firestaradmin/WorldEdit-No.1/README.md

# 概要
基于STM32，极度硬核DIY蓝牙机械键盘，整个项目涵盖了 选轴体，键盘阵列排版，PCB设计，程序设计，外壳CNC制作。
