firestaradmin/WorldEdit-No.1/Code/WorldEdit_No_1_F103RCT6/DOC/ReadMe.txt

/************************************************************************************
*  Copyright (c), 2019, LXG.
*
* FileName		:ReadMe.txt
* Author		:firestaradmin
* Version		:1.3.2
*
*
*************************************************************************************/

================================================
History:
-------------------------------------------------
2020/1/29 :Version 1.3.2
增加了FN组合功能键， Consumer 按键 如音量加减等操作
修改USB模式的LOGO灯的常亮为可控制模式
-------------------------------------------------
2020/1/5 :Version 1.3.1
LED灯控关闭会自动点亮的bug被修复。
-------------------------------------------------
2019/12/20  ：Version:1.3
更新了USB——HID连接模式，响应时间有巨幅提高。游戏不在话下 
BLUETEETH_Mode:
响应时间:    14.07ms

USB_Mode:
响应时间：	0.34ms

-------------------------------------------------
2019/12/18  ：Version:1.2
bug修复
增加了键盘LED灯阵的操控
进一步提高了蓝牙的响应速度
但蓝牙模块已经到达极限速度，最快响应时间也不过15ms尔尔

-------------------------------------------------
2019/12/15  ：Version:1.0

键盘可以正常使用，有时候有一些bug
