firestaradmin/WorldEdit-No.1/LayOut/87.png

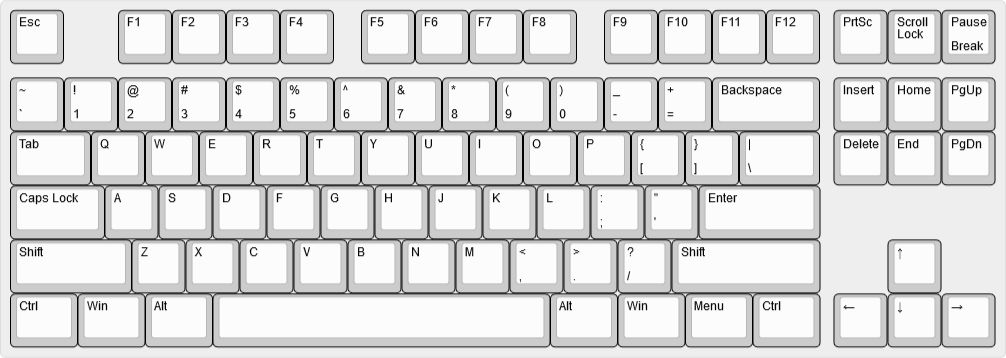
LayOut/87.png
