firestaradmin/WorldEdit-No.1/LayOut/89键盘矩阵.png

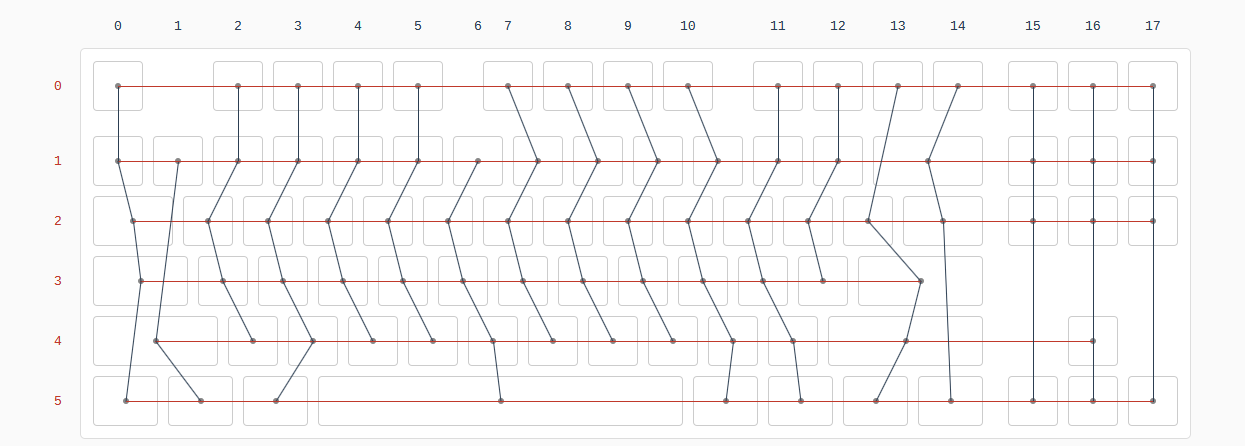
LayOut/89键盘矩阵.png
