firestaradmin/WorldEdit-No.1/PCB/创世一号/创世一号BOM.xls

Comment | Description | Designator | Footprint | LibRef | Quantity
HDR2x3 | Connector | BOOT | PIN-2x3-2.54-1.0 | HDR2x3 | 1
BTK-05-blueteeth |  | BTK-05 | BTK-05-bluteeth | BTK-05-blueteeth | 1
22pF | Capacitor | C1, C2 | RC0603 | CAP1 | 2
104 | Capacitor | C3, C4, C5, C6, C8 | RC0603 | CAP1 | 5
10uf | Tantalum Capacitor | C7 | CAP0805 | CAP-TANTALUM | 1
105 | Capacitor | C9, C12, C13, C16 | 0603 | CAP | 4
22nf | Capacitor | C10, C14 | 0603 | CAP | 2
104 | Capacitor | C11, C15 | 0603 | CAP | 2
10uf | Capacitor | C18, C19 | 0805 | CAP | 2
LED | LED | CAPS_LED, LED1, LED2, LED3, LED4, LED5, LED6, LED7, LED8, LED_CHRG, PWR, STATE_LED | LED-0805 | LED | 12
Diode |  | D2, D3, D4, D5, D6, D7, D8, D9, D10, D11, D12, D13, D14, D15, D16, D17, D18, D19, D20, D21, D22, D23, D24, D25, D26, D27, D28, D29, D30, D31, D32, D33, D34, D35, D36, D37, D38, D39, D40, D41, D42, D43, D44, D45, D46, D47, D48, D49, D50, D51, D52, D53, D54, D55, D56, D57, D58, D59, D60, D61, D62, D63, D64, D66, D67, D68, D69, D70, D71, D72, D73, D74, D75, D76, D77, D78, D82, D83, D84, D85, D86, D87, D88, D89, D90, D91, D92 | SDO-123 | Diode | 87
500mA | Resistor | F1 | 0805 | Res2 | 1
MX_SW | with Fixation pins 1-Pole w/LED | KEY_0, KEY_1, KEY_2, KEY_3, KEY_4, KEY_5, KEY_6, KEY_7, KEY_8, KEY_9, KEY_-, KEY_", KEY_/, KEY_;, KEY_[, KEY_\, KEY_], KEY_`, KEY_<, KEY_=, KEY_>, KEY_A, KEY_Alt, KEY_Alt2, KEY_B, KEY_Backspace, KEY_C, KEY_CapsLock, KEY_Ctrl, KEY_Ctrl2, KEY_D, KEY_Delete, KEY_Down, KEY_E, KEY_End, KEY_Enter, KEY_ESC, KEY_F, KEY_F1, KEY_F2, KEY_F3, KEY_F4, KEY_F5, KEY_F6, KEY_F7, KEY_F8, KEY_F9, KEY_F10, KEY_F11, KEY_F12, KEY_FN, KEY_G, KEY_H, KEY_Home, KEY_I, KEY_Insert, KEY_J, KEY_K, KEY_L, KEY_Left, KEY_M, KEY_Menu, KEY_N, KEY_O, KEY_P, KEY_PageDown, KEY_PageUp, KEY_Pause, KEY_PrtSc, KEY_Q, KEY_R, KEY_Right, KEY_S, KEY_ScrollLock, KEY_Shift, KEY_Shift2, KEY_Space, KEY_T, KEY_Tab, KEY_U, KEY_Up, KEY_V, KEY_W, KEY_Win, KEY_X, KEY_Y, KEY_Z | MX_SW-5 | MX_SW-5 | 87
HDR1x3 | Connector | LEDPwrCON | PIN-3-2.54-1.0 | HDR1x3 | 1
HDR1x2 | Connector | Power | PIN-2-2.54-1.0 | HDR1x2 | 1
NPN | NPN Bipolar Transistor | Q1 | S8050-TO-92 | NPN | 1
1M |  | R1 | RC0603 | R | 1
0R |  | R2 | RC0603 | R | 1
10K |  | R3, R4, R5 | RC0603 | R | 3
1k | Resistor, [NoValue] | R6, R7, R9, R13, R15, | 0603 | RES, R, Res2 | 5
1.5K | Resistor | R10 | 0603 | Res2 | 1
22R | Resistor | R11, R12,R17 | 0603 | Res2 | 3
10k | Resistor | R16 | 0603 | Res2 | 1
2k | Resistor | RPROG | 0603 | RES | 1
SW-SPST | Single-Pole, Single-Throw Switch | S1 | SMT-KEY | SW-SPST | 1
SWITCH-SPST | Switch | SW_PWR | Switch_3p_2.5mmjianju | SWITCH-SPST | 1
HDR1x4 | Connector | SWD | PIN-4-2.54-1.0 | HDR1x4 | 1
STM32F103RCT6 | MCU | U1 | QFP-64-0.5 | STM32F103RxTx | 1
HT16K33 SOP-28 |  | U2 | HT16K33-28PIN-SOP28 | HT16K33 SOP-28 | 1
RT9193 |  | U3, U4 | SOT-23-5 | RT9193 | 2
TP4056 |  | U5 | ESOP8 | TP4056 | 1
USB Slave_c | USB Connector | USB | MICRO USB CONNECTOR TYPEB-ST-MC-5F-01 | MICRO USB CONNECTOR TYPEB | 1
8M | Crystal Oscillator | X1 | HC49-SMD | XTAL_SMD | 1
名称 | 描述 | 封装 | 数量
HDR2x3 | Connector | PIN-2x3-2.54-1.0 | 1
BTK-05-blueteeth | 蓝牙HID模块 | BTK-05-bluteeth | 1
22pF | Capacitor | RC0603 | 2
104 | Capacitor | RC0603 | 5
10uf | Tantalum Capacitor | CAP0805 | 1
105 | Capacitor | 0603 | 4
22nf | Capacitor | 0603 | 2
104 | Capacitor | 0603 | 2
10uf | Capacitor | 0805 | 2
LED | LED | LED-0805 | 12
Diode | 二极管 | SDO-123 | 87
500mA | 限流保险管 | 0805 | 1
MX_SW | 键盘轴体 | MX_SW-5 | 87
HDR1x3 | Connector | PIN-3-2.54-1.0 | 1
HDR1x2 | Connector | PIN-2-2.54-1.0 | 1
NPN | NPN Bipolar Transistor | S8050-TO-92 | 1
1M |  | RC0603 | 1
0R |  | RC0603 | 1
10K |  | RC0603 | 3
1k | Resistor, [NoValue] | 0603 | 5
1.5K | Resistor | 0603 | 1
22R | Resistor | 0603 | 3
10k | Resistor | 0603 | 1
2k | Resistor | 0603 | 1
SW-SPST | 按键 | SMT-KEY | 1
SWITCH-SPST | 开关 | Switch_3p_2.5mmjianju | 1
HDR1x4 | Connector | PIN-4-2.54-1.0 | 1
STM32F103RCT6 | MCU主控 | QFP-64-0.5 | 1
HT16K33 SOP-28 | 灯控 | HT16K33-28PIN-SOP28 | 1
RT9193 | 稳压 | SOT-23-5 | 2
TP4056 | 电源管理 | ESOP8 | 1
USB Slave_c | MicroUSB母座 | MICRO USB CONNECTOR TYPEB-ST-MC-5F-01 | 1
8M | 晶振 | HC49-SMD | 1
