firestaradmin/WorldEdit-No.1/LayOut/87BOM.png

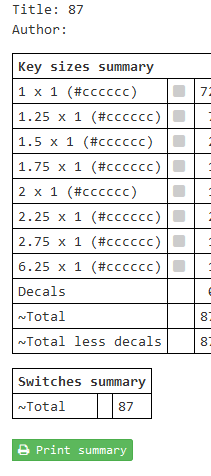
LayOut/87BOM.png
