firestaradmin/WorldEdit-No.1/PCB/创世一号/创世一号pcb.DXF

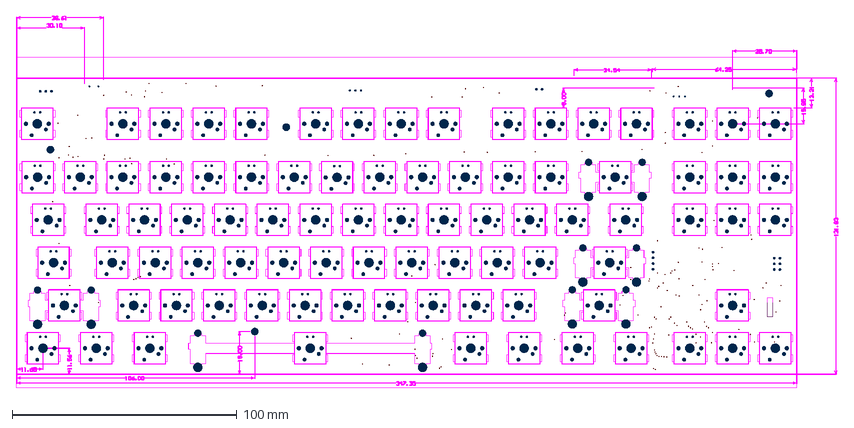
[picture p4: CAD file, 2019-12-28]
PCB/创世一号/创世一号pcb.DXF
366.0 x 165.4 mm
