firestaradmin/WorldEdit-No.1/SolidWorks外壳/平板型式 - 键盘钣金.DXF

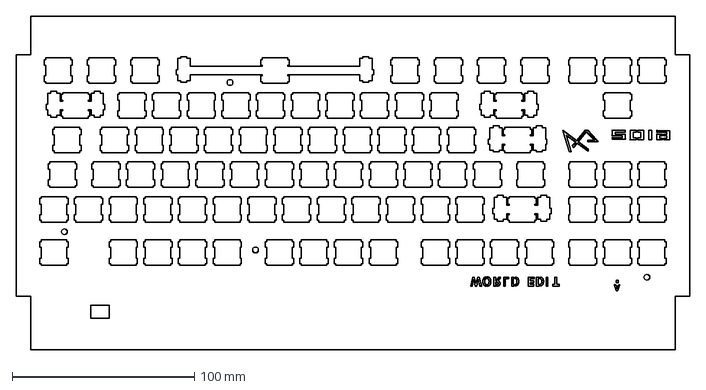
[picture p5: CAD file, 2019-12-28]
SolidWorks外壳/平板型式 - 键盘钣金.DXF
370.1 x 183.2 mm
