firestaradmin/WorldEdit-No.1/SolidWorks外壳/87layout.dxf

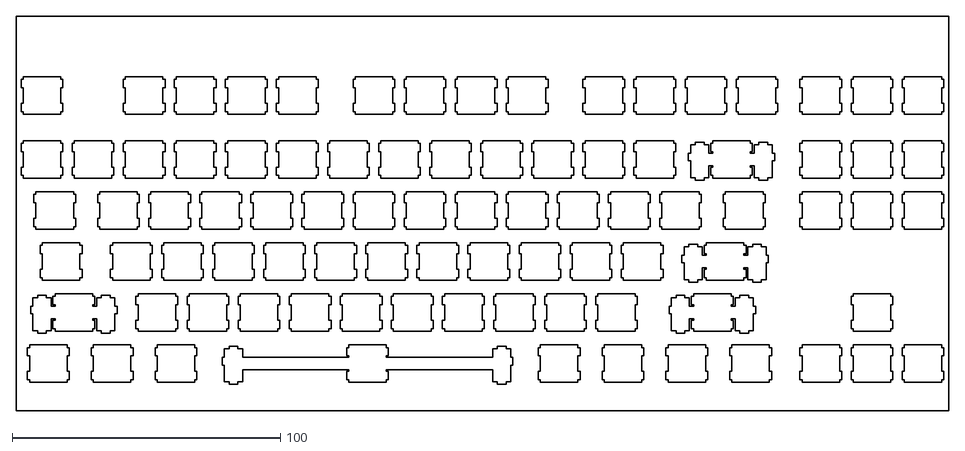
[picture p6: CAD file, 2019-12-28]
SolidWorks外壳/87layout.dxf
347.7 x 147.1
