firestaradmin/WorldEdit-No.1/PCB/创世一号/创世一号.pdf

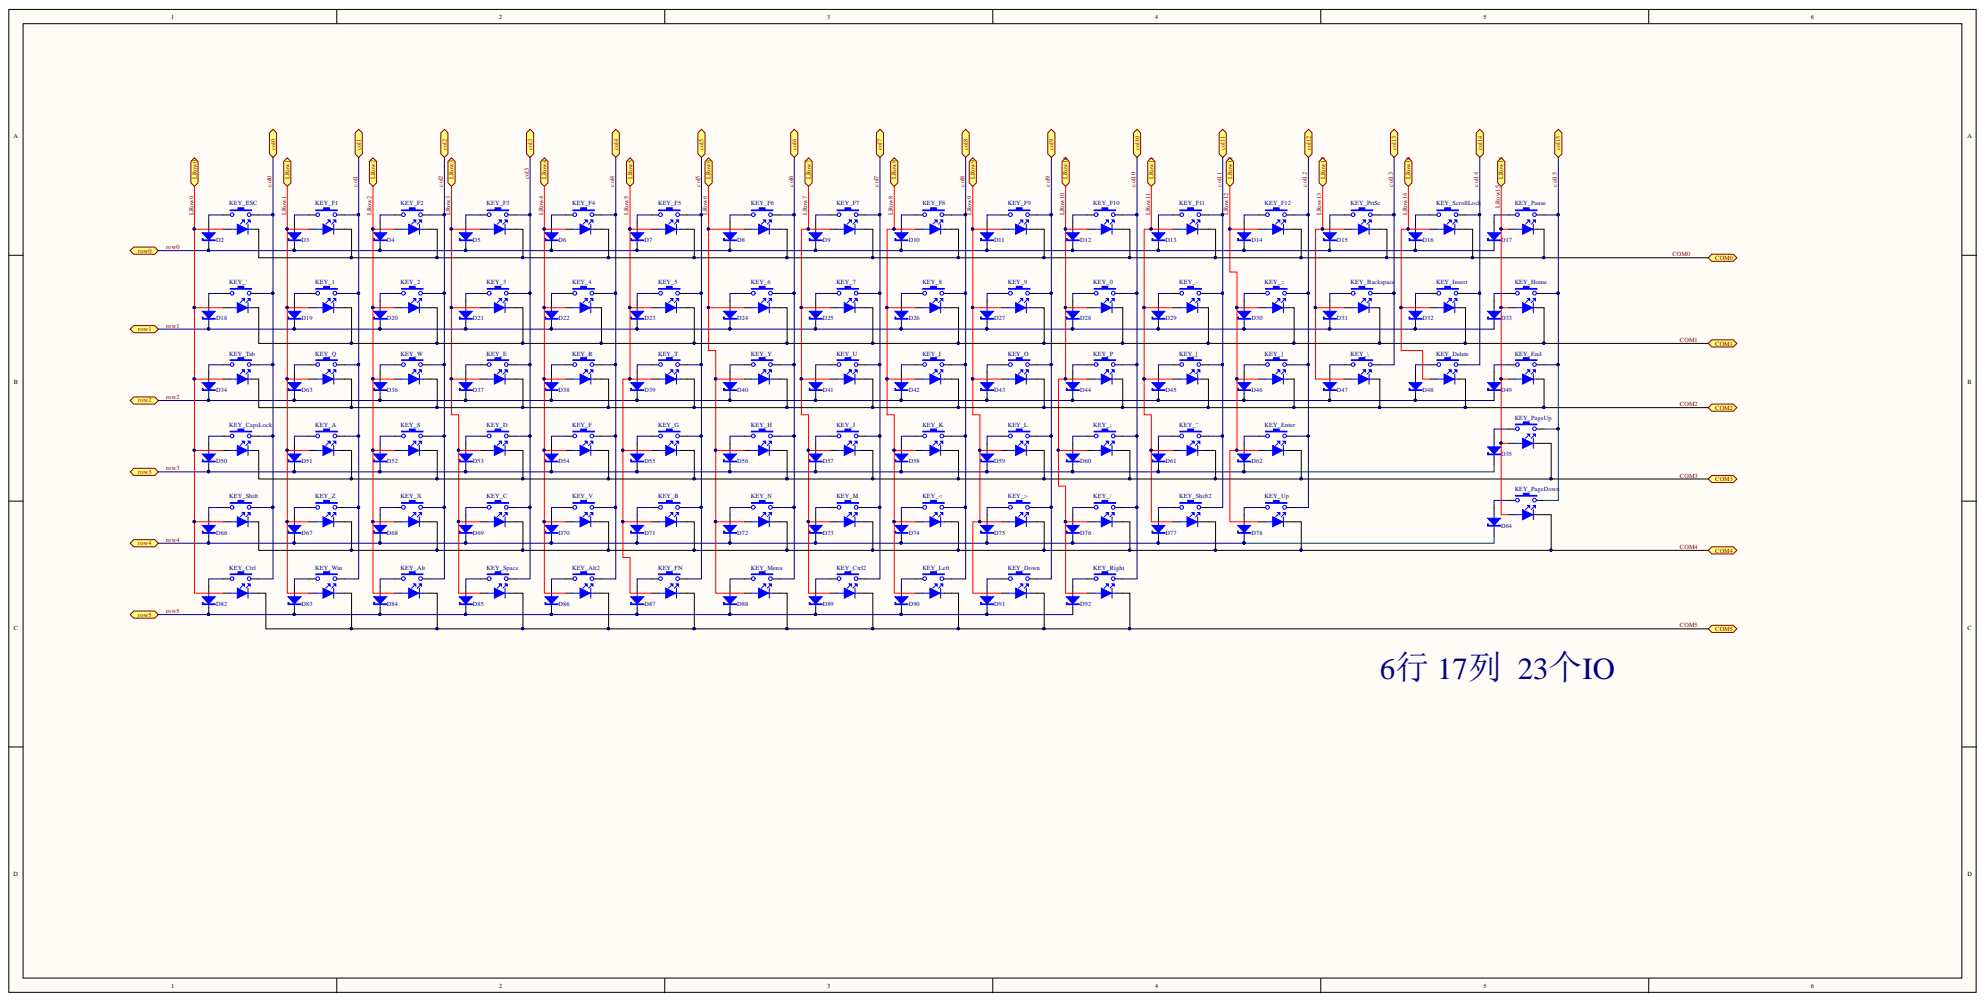
[picture p7: page 1]

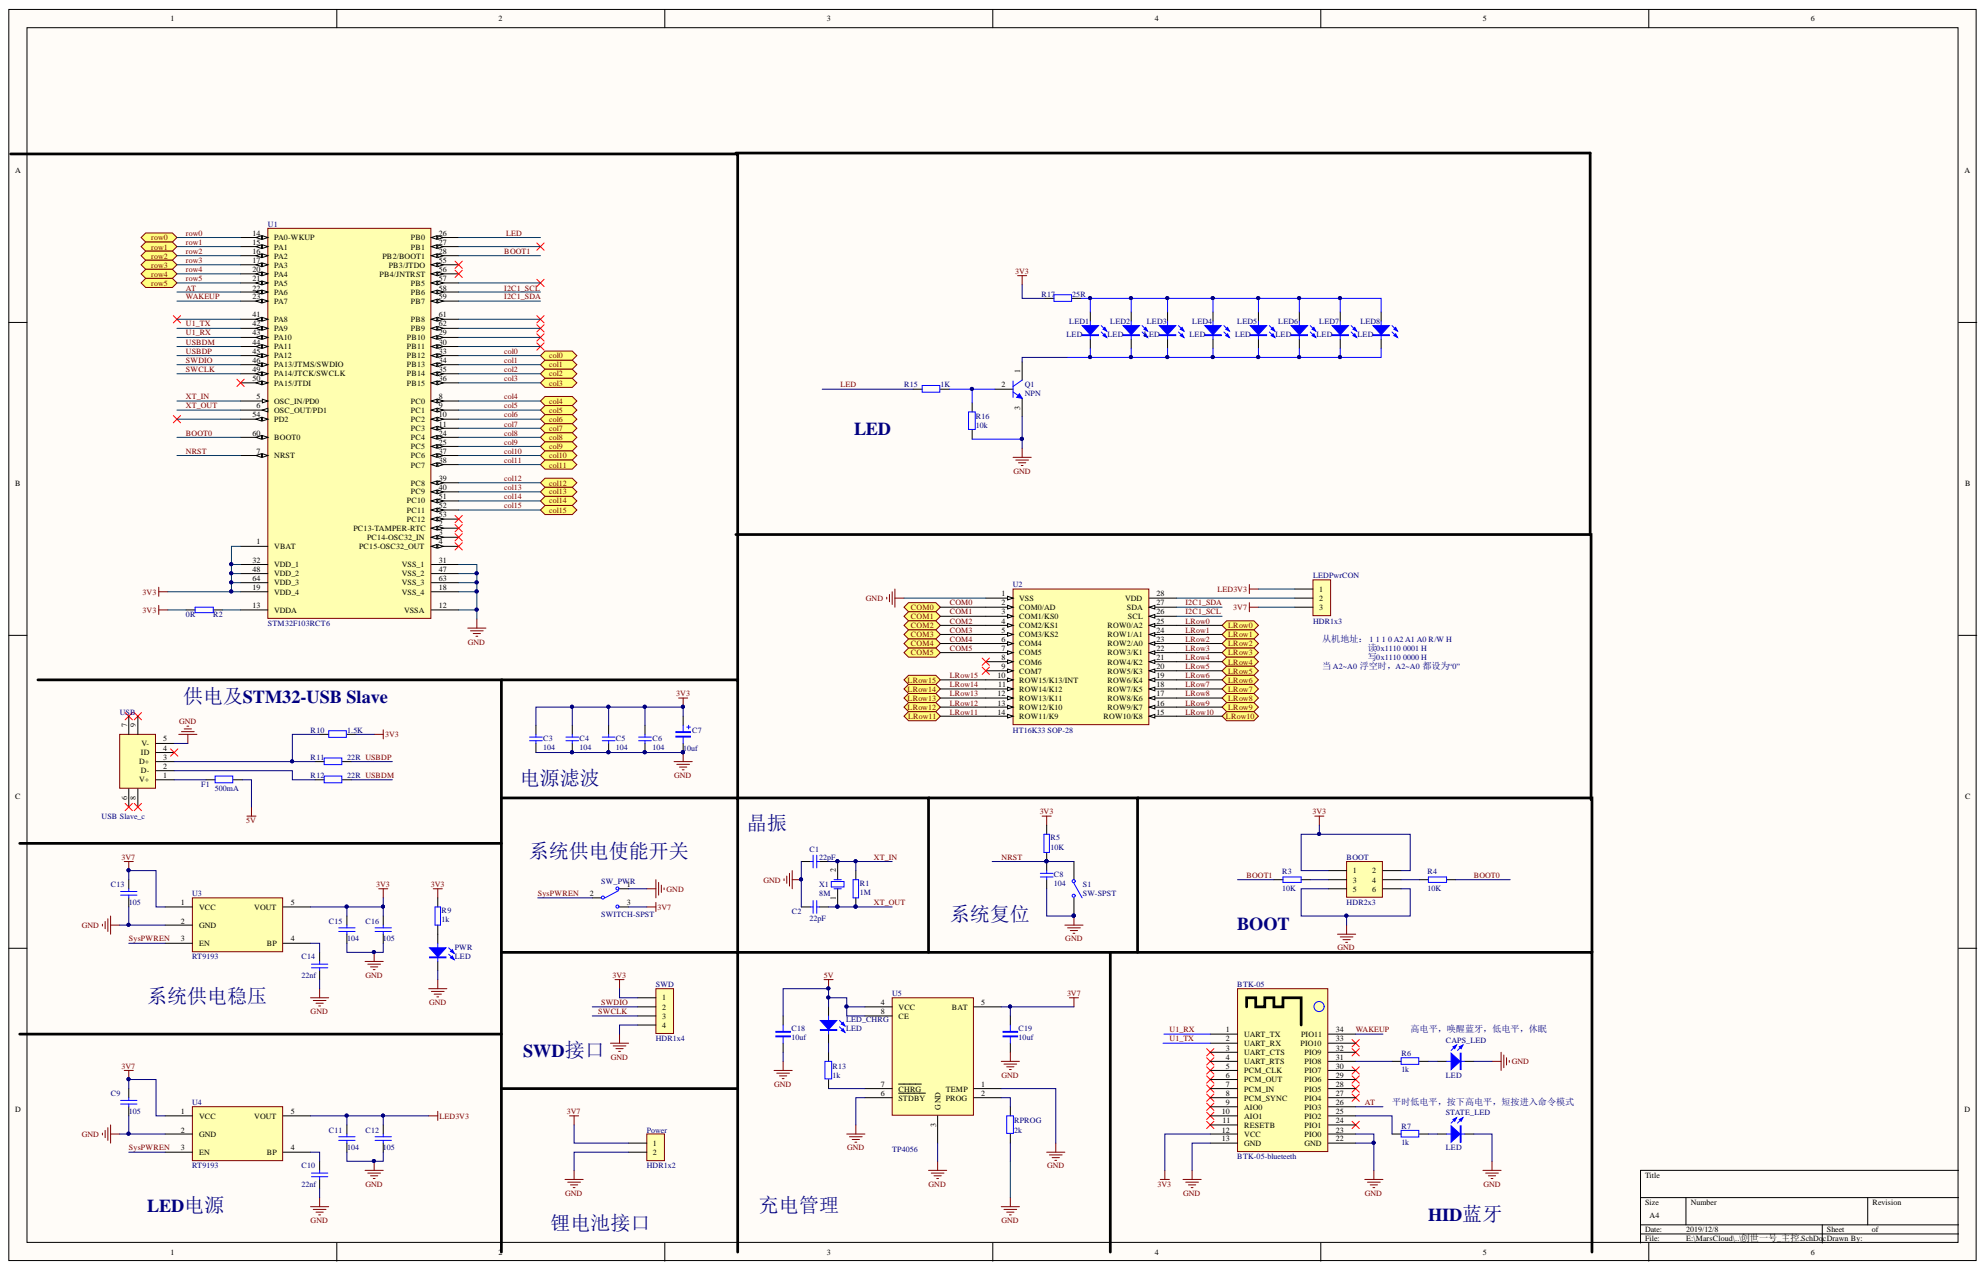
[picture p8: page 2]

LEDPwrCON

系统供电使能开关 | 晶振 XT_IN C2 22pF | 3V3 NRST C1 | 3V3 BOOT

高电平，唤醒蓝牙，低电平，休眠
