firestaradmin/WorldEdit-No.1/(list of files, drawings)

Other design files:
PCB/创世一号/KeyBoard.PcbLib
PCB/创世一号/KeyBoard.SchLib
PCB/创世一号/创世一号.PrjPCB
PCB/创世一号/创世一号_主控.SchDoc
PCB/创世一号/创世一号_键轴.SchDoc
PCB/创世一号/卫星轴.PcbLib
