firestaradmin/WorldEdit-No.1/Code/WorldEdit_No_1_F103RCT6/USBLib/CONFIG/platform_config.h

/**
  ******************************************************************************
  * @file    platform_config.h
  * @author  MCD Application Team
  * @version V4.0.0
  * @date    21-January-2013
  * @brief   Evaluation board specific configuration file.
  ******************************************************************************
  * @attention
  *
  * <h2><center>&copy; COPYRIGHT 2013 STMicroelectronics</center></h2>
  *
  * Licensed under MCD-ST Liberty SW License Agreement V2, (the "License");
  * You may not use this file except in compliance with the License.
  * You may obtain a copy of the License at:
  *
  *        http://www.st.com/software_license_agreement_liberty_v2
  *
  * Unless required by applicable law or agreed to in writing, software 
  * distributed under the License is distributed on an "AS IS" BASIS, 
  * WITHOUT WARRANTIES OR CONDITIONS OF ANY KIND, either express or implied.
  * See the License for the specific language governing permissions and
  * limitations under the License.
  *
  ******************************************************************************
  */


/* Define to prevent recursive inclusion -------------------------------------*/
#ifndef __PLATFORM_CONFIG_H
#define __PLATFORM_CONFIG_H

/* Includes ------------------------------------------------------------------*/
//#include "sys.h"
#include "stm32f10x.h"

/* Exported types ------------------------------------------------------------*/
/* Exported constants --------------------------------------------------------*/
/* Uncomment the line corresponding to the STMicroelectronics evaluation board
   used to run the example */
#if !defined (USE_STM3210B_EVAL) &&  !defined (USE_STM3210E_EVAL) &&  !defined (USE_STM32L152_EVAL) &&  !defined (USE_STM32L152D_EVAL)&&  !defined (USE_STM32373C_EVAL) &&  !defined (USE_STM32303C_EVAL)
 //#define USE_STM3210B_EVAL
 //#define USE_STM3210E_EVAL
 //#define USE_STM32L152_EVAL
//#define USE_STM32L152D_EVAL
//#define USE_STM32373C_EVAL
 //#define USE_STM32303C_EVAL
#endif

/*Unique Devices IDs register set*/

#if defined(STM32L1XX_MD) || defined(STM32L1XX_HD) || defined(STM32L1XX_MD_PLUS) 

#define         ID1          (0x1FF80050)
#define         ID2          (0x1FF80054)
#define         ID3          (0x1FF80064)

#elif defined (STM32F37X) || defined(STM32F30X)

#define         ID1          (0x1FFFF7AC)
#define         ID2          (0x1FFFF7B0)
#define         ID3          (0x1FFFF7B4)

#else /*STM32F1x*/

#define         ID1          (0x1FFFF7E8)
#define         ID2          (0x1FFFF7EC)
#define         ID3          (0x1FFFF7F0)

#endif

/* Define the STM32F10x hardware depending on the used evaluation board */
#ifdef USE_STM3210B_EVAL
  #define USB_DISCONNECT                      GPIOD  
  #define USB_DISCONNECT_PIN                  GPIO_Pin_9
  
  #define RCC_APB2Periph_GPIO_DISCONNECT      RCC_APB2Periph_GPIOD

  #define RCC_APB2Periph_ALLGPIO              (RCC_APB2Periph_GPIOA \
                                               | RCC_APB2Periph_GPIOB \
                                               | RCC_APB2Periph_GPIOC \
                                               | RCC_APB2Periph_GPIOD \
                                               | RCC_APB2Periph_GPIOE )

#elif defined (USE_STM3210E_EVAL)
  #define USB_DISCONNECT                      GPIOB  
  #define USB_DISCONNECT_PIN                  GPIO_Pin_14
  #define RCC_APB2Periph_GPIO_DISCONNECT      RCC_APB2Periph_GPIOB
                                                
  #define RCC_APB2Periph_ALLGPIO              (RCC_APB2Periph_GPIOA \
                                               | RCC_APB2Periph_GPIOB \
                                               | RCC_APB2Periph_GPIOC \
                                               | RCC_APB2Periph_GPIOD \
                                               | RCC_APB2Periph_GPIOE \
                                               | RCC_APB2Periph_GPIOF \
                                               | RCC_APB2Periph_GPIOG )

#elif defined (USE_STM32L152_EVAL) || defined (USE_STM32L152D_EVAL)
 /* 
   For STM32L15xx devices it is possible to use the internal USB pullup
   controlled by register SYSCFG_PMC (refer to RM0038 reference manual for
   more details).
   It is also possible to use external pullup (and disable the internal pullup)
   by setting the define USB_USE_EXTERNAL_PULLUP in file platform_config.h
   and configuring the right pin to be used for the external pull up configuration.
   To have more details on how to use an external pull up, please refer to 
   STM3210E-EVAL evaluation board manuals.
   */
 /* Uncomment the following define to use an external pull up instead of the 
    integrated STM32L15xx internal pull up. In this case make sure to set up
    correctly the external required hardware and the GPIO defines below.*/
/* #define USB_USE_EXTERNAL_PULLUP */

 #if !defined(USB_USE_EXTERNAL_PULLUP)
  #define STM32L15_USB_CONNECT                SYSCFG_USBPuCmd(ENABLE)
  #define STM32L15_USB_DISCONNECT             SYSCFG_USBPuCmd(DISABLE)

 #elif defined(USB_USE_EXTERNAL_PULLUP)
  /* PA0 is chosen just as illustrating example, you should modify the defines
    below according to your hardware configuration. */
  #define USB_DISCONNECT                      GPIOA
  #define USB_DISCONNECT_PIN                  GPIO_Pin_0
  #define RCC_AHBPeriph_GPIO_DISCONNECT       RCC_AHBPeriph_GPIOA
  #define STM32L15_USB_CONNECT                GPIO_ResetBits(USB_DISCONNECT, USB_DISCONNECT_PIN)
  #define STM32L15_USB_DISCONNECT             GPIO_SetBits(USB_DISCONNECT, USB_DISCONNECT_PIN)
 #endif /* USB_USE_EXTERNAL_PULLUP */
                                                
  #define RCC_AHBPeriph_ALLGPIO               (RCC_AHBPeriph_GPIOA \
                                               | RCC_AHBPeriph_GPIOB \
                                               | RCC_AHBPeriph_GPIOC \
                                               | RCC_AHBPeriph_GPIOD \
                                               | RCC_AHBPeriph_GPIOE \
										       | RCC_AHBPeriph_GPIOF \
                                               | RCC_AHBPeriph_GPIOH)
#elif defined (USE_STM32373C_EVAL)

  #define USB_DISCONNECT                      GPIOC  
  #define USB_DISCONNECT_PIN                  GPIO_Pin_5
  #define RCC_AHBPeriph_GPIO_DISCONNECT       RCC_AHBPeriph_GPIOC
 
  #define GPIO_Pin_KEY                        GPIO_Pin_6   /* PE.6 */
  #define GPIO_Pin_UP                         GPIO_Pin_10  /* PF.10 */
  #define GPIO_Pin_DOWN                       GPIO_Pin_2  /* PF.2 */
  #define GPIO_Pin_LEFT                       GPIO_Pin_4  /* PF.4 */
  #define GPIO_Pin_RIGHT                      GPIO_Pin_9  /* PF.9 */
  
  #define RCC_AHBPeriph_GPIO_JOY_SET1        RCC_AHBPeriph_GPIOF

  #define GPIO_RIGHT                          GPIOF
  #define GPIO_LEFT                           GPIOF
  #define GPIO_DOWN                           GPIOF
  #define GPIO_UP                             GPIOF
  #define GPIO_KEY                            GPIOE

#elif defined (USE_STM32303C_EVAL)

  #define USB_DISCONNECT                      GPIOB  
  #define USB_DISCONNECT_PIN                  GPIO_Pin_8
  #define RCC_AHBPeriph_GPIO_DISCONNECT       RCC_AHBPeriph_GPIOB

 
  #define GPIO_Pin_KEY                        GPIO_Pin_6   /* PE.6 */
  #define GPIO_Pin_UP                         GPIO_Pin_7  /* PE.7 */
  #define GPIO_Pin_DOWN                       GPIO_Pin_5  /* PD.5 */
  #define GPIO_Pin_LEFT                       GPIO_Pin_5  /* PB.4 */
  #define GPIO_Pin_RIGHT                      GPIO_Pin_6  /* PD.2 */
  
  #define RCC_AHBPeriph_GPIO_JOY_SET1        RCC_AHBPeriph_GPIOF

  #define GPIO_RIGHT                          GPIOD
  #define GPIO_LEFT                           GPIOB
  #define GPIO_DOWN                           GPIOD
  #define GPIO_UP                             GPIOE
  #define GPIO_KEY                            GPIOE

                                     
#define RCC_AHBPeriph_ALLGPIO                 (RCC_AHBPeriph_GPIOA \
                                              | RCC_AHBPeriph_GPIOB \
                                              | RCC_AHBPeriph_GPIOC \
                                              | RCC_AHBPeriph_GPIOD \
                                              | RCC_AHBPeriph_GPIOE \
                                              | RCC_AHBPeriph_GPIOF )
#define GPIO_KEY_EXTI_Line                  EXTI_Line18
#endif /* USE_STM3210B_EVAL */

/* Exported macro ------------------------------------------------------------*/
/* Exported functions ------------------------------------------------------- */

#endif /* __PLATFORM_CONFIG_H */

/************************ (C) COPYRIGHT STMicroelectronics *****END OF FILE****/
