firestaradmin/WorldEdit-No.1/(commit log)

2019-12-28 Add Version 1.0
    [87layout.dxf, KeyBoard.PcbLib, KeyBoard.SchLib, 创世一号.PrjPCB, 创世一号BOM.xls, 创世一号_主控.SchDoc, 创世一号_键轴.SchDoc, 创世一号pcb.DXF]
2020-01-06 修复了PCB文件，增加了PWR主控休眠
2020-01-06 PCB铺铜修复
    [创世一号BOM.xls]
2020-10-08 2020年10月8日 修复pcb bug
    [87layout.dxf, 创世一号.PrjPCB, 创世一号_主控.SchDoc, 平板型式 - 键盘钣金.DXF]
